Max-Ferrando/Proyecto3_ASIC_Grupo7/sim/asic/gen/game_rom.v

// GENERADO por tools/rvasm.py a partir de sw/game.s. NO EDITAR.
// Constantes redefinidas: CLK_HZ=20000
// ROM combinacional: 150 de 256 palabras usadas.
// Las direcciones sin programa devuelven 0 (instruccion ilegal).
module pochoco_game_rom (
  input  wire [7:0] addr_i,   // direccion de palabra
  output reg  [31:0] data_o
);
  always @* begin
    case (addr_i)
      8'd0: data_o = 32'h80000437;  // li   s0, PERIPH
      8'd1: data_o = 32'h000011b7;  // li   gp, 0x1234
      8'd2: data_o = 32'h23418193;
      8'd3: data_o = 32'h00042023;  // sw   zero, SEG_OFF(s0)
      8'd4: data_o = 32'h00100613;  // li   a2, 1
      8'd5: data_o = 32'h00c42223;  // sw   a2, LED_OFF(s0)
      8'd6: data_o = 32'h00001537;  // li   a0, IDLE_STEP
      8'd7: data_o = 32'hfa050513;
      8'd8: data_o = 32'h14c000ef;  // jal  ra, wait_or_press
      8'd9: data_o = 32'h00051c63;  // bnez a0, idle_pressed
      8'd10: data_o = 32'h00c60633;  // add  a2, a2, a2
      8'd11: data_o = 32'h01000293;  // li   t0, 16
      8'd12: data_o = 32'hfe5612e3;  // bne  a2, t0, idle_loop
      8'd13: data_o = 32'h00100613;  // li   a2, 1
      8'd14: data_o = 32'hfddff06f;  // j    idle_loop
      8'd15: data_o = 32'h00c42283;  // lw   t0, CYC_OFF(s0)
      8'd16: data_o = 32'h0051c1b3;  // xor  gp, gp, t0
      8'd17: data_o = 32'h150000ef;  // jal  ra, wait_release
      8'd18: data_o = 32'h00000493;  // li   s1, 0
      8'd19: data_o = 32'h00000213;  // li   tp, 0
      8'd20: data_o = 32'h00f00293;  // li   t0, 15
      8'd21: data_o = 32'h00542223;  // sw   t0, LED_OFF(s0)
      8'd22: data_o = 32'h0000f537;  // li   a0, ALL_ON_TIME
      8'd23: data_o = 32'ha6050513;
      8'd24: data_o = 32'h0f8000ef;  // jal  ra, delay
      8'd25: data_o = 32'h130000ef;  // jal  ra, wait_release
      8'd26: data_o = 32'h14c000ef;  // jal  ra, rand_led
      8'd27: data_o = 32'h00f42223;  // sw   a5, LED_OFF(s0)
      8'd28: data_o = 32'h00c42703;  // lw   a4, CYC_OFF(s0)
      8'd29: data_o = 32'h00c42583;  // lw   a1, CYC_OFF(s0)
      8'd30: data_o = 32'h00842503;  // lw   a0, BTN_OFF(s0)
      8'd31: data_o = 32'hfe050ce3;  // beqz a0, wait_press
      8'd32: data_o = 32'h40e585b3;  // sub  a1, a1, a4
      8'd33: data_o = 32'h00b181b3;  // add  gp, gp, a1
      8'd34: data_o = 32'h08f51863;  // bne  a0, a5, wrong_button
      8'd35: data_o = 32'h000302b7;  // li   t0, MAX_CYCLES
      8'd36: data_o = 32'h57028293;
      8'd37: data_o = 32'h0055e463;  // bltu a1, t0, no_sat
      8'd38: data_o = 32'h00028593;  // mv   a1, t0
      8'd39: data_o = 32'h00b20233;  // add  tp, tp, a1
      8'd40: data_o = 32'h3e800293;  // li   t0, HALF_TENTH
      8'd41: data_o = 32'h00558533;  // add  a0, a1, t0
      8'd42: data_o = 32'h7d000593;  // li   a1, TENTH
      8'd43: data_o = 32'h154000ef;  // jal  ra, udiv
      8'd44: data_o = 32'h16c000ef;  // jal  ra, to_bcd
      8'd45: data_o = 32'h00a42023;  // sw   a0, SEG_OFF(s0)
      8'd46: data_o = 32'h0dc000ef;  // jal  ra, wait_release
      8'd47: data_o = 32'h00148493;  // addi s1, s1, 1
      8'd48: data_o = 32'h00a00293;  // li   t0, NUM_ROUNDS
      8'd49: data_o = 32'hf854c6e3;  // blt  s1, t0, round_start
      8'd50: data_o = 32'h000022b7;  // li   t0, NUM_ROUNDS * TENTH / 2
      8'd51: data_o = 32'h71028293;
      8'd52: data_o = 32'h00520533;  // add  a0, tp, t0
      8'd53: data_o = 32'h000055b7;  // li   a1, NUM_ROUNDS * TENTH
      8'd54: data_o = 32'he2058593;
      8'd55: data_o = 32'h124000ef;  // jal  ra, udiv
      8'd56: data_o = 32'h13c000ef;  // jal  ra, to_bcd
      8'd57: data_o = 32'h00a42023;  // sw   a0, SEG_OFF(s0)
      8'd58: data_o = 32'h00500613;  // li   a2, 5
      8'd59: data_o = 32'h00c42223;  // sw   a2, LED_OFF(s0)
      8'd60: data_o = 32'h00001537;  // li   a0, IDLE_STEP
      8'd61: data_o = 32'hfa050513;
      8'd62: data_o = 32'h074000ef;  // jal  ra, wait_or_press
      8'd63: data_o = 32'h00051663;  // bnez a0, end_pressed
      8'd64: data_o = 32'h00f64613;  // xori a2, a2, 15
      8'd65: data_o = 32'hfe9ff06f;  // j    end_loop
      8'd66: data_o = 32'h00c42283;  // lw   t0, CYC_OFF(s0)
      8'd67: data_o = 32'h0051c1b3;  // xor  gp, gp, t0
      8'd68: data_o = 32'h084000ef;  // jal  ra, wait_release
      8'd69: data_o = 32'hef9ff06f;  // j    new_game
      8'd70: data_o = 32'h0ee00293;  // li   t0, ERR_CODE
      8'd71: data_o = 32'h00542023;  // sw   t0, SEG_OFF(s0)
      8'd72: data_o = 32'h074000ef;  // jal  ra, wait_release
      8'd73: data_o = 32'h00300613;  // li   a2, ERR_BLINKS
      8'd74: data_o = 32'h00f00293;  // li   t0, 15
      8'd75: data_o = 32'h00542223;  // sw   t0, LED_OFF(s0)
      8'd76: data_o = 32'h00001537;  // li   a0, BLINK_TIME
      8'd77: data_o = 32'hbb850513;
      8'd78: data_o = 32'h020000ef;  // jal  ra, delay
      8'd79: data_o = 32'h00042223;  // sw   zero, LED_OFF(s0)
      8'd80: data_o = 32'h00001537;  // li   a0, BLINK_TIME
      8'd81: data_o = 32'hbb850513;
      8'd82: data_o = 32'h010000ef;  // jal  ra, delay
      8'd83: data_o = 32'hfff60613;  // addi a2, a2, -1
      8'd84: data_o = 32'hfc061ce3;  // bnez a2, err_loop
      8'd85: data_o = 32'hefdff06f;  // j    round_start
      8'd86: data_o = 32'h00c42283;  // lw   t0, CYC_OFF(s0)
      8'd87: data_o = 32'h00c42303;  // lw   t1, CYC_OFF(s0)
      8'd88: data_o = 32'h40530333;  // sub  t1, t1, t0
      8'd89: data_o = 32'hfea36ce3;  // bltu t1, a0, delay_loop
      8'd90: data_o = 32'h00008067;  // ret
      8'd91: data_o = 32'h00c42283;  // lw   t0, CYC_OFF(s0)
      8'd92: data_o = 32'h00842303;  // lw   t1, BTN_OFF(s0)
      8'd93: data_o = 32'h00031c63;  // bnez t1, wop_hit
      8'd94: data_o = 32'h00c42383;  // lw   t2, CYC_OFF(s0)
      8'd95: data_o = 32'h405383b3;  // sub  t2, t2, t0
      8'd96: data_o = 32'hfea3e8e3;  // bltu t2, a0, wop_loop
      8'd97: data_o = 32'h00000513;  // li   a0, 0
      8'd98: data_o = 32'h00008067;  // ret
      8'd99: data_o = 32'h00030513;  // mv   a0, t1
      8'd100: data_o = 32'h00008067;  // ret
      8'd101: data_o = 32'h19000693;  // li   a3, DEBOUNCE
      8'd102: data_o = 32'h00c42283;  // lw   t0, CYC_OFF(s0)
      8'd103: data_o = 32'h00842303;  // lw   t1, BTN_OFF(s0)
      8'd104: data_o = 32'hfe031ce3;  // bnez t1, wr_restart
      8'd105: data_o = 32'h00c42383;  // lw   t2, CYC_OFF(s0)
      8'd106: data_o = 32'h405383b3;  // sub  t2, t2, t0
      8'd107: data_o = 32'hfed3e8e3;  // bltu t2, a3, wr_loop
      8'd108: data_o = 32'h00008067;  // ret
      8'd109: data_o = 32'h003182b3;  // add  t0, gp, gp
      8'd110: data_o = 32'h005282b3;  // add  t0, t0, t0
      8'd111: data_o = 32'h003281b3;  // add  gp, t0, gp
      8'd112: data_o = 32'h000032b7;  // li   t0, LCG_INC
      8'd113: data_o = 32'h03928293;
      8'd114: data_o = 32'h005181b3;  // add  gp, gp, t0
      8'd115: data_o = 32'h00c42283;  // lw   t0, CYC_OFF(s0)
      8'd116: data_o = 32'h005181b3;  // add  gp, gp, t0
      8'd117: data_o = 32'h00100793;  // li   a5, 1
      8'd118: data_o = 32'h00010337;  // lui  t1, 0x10
      8'd119: data_o = 32'h0061f2b3;  // and  t0, gp, t1
      8'd120: data_o = 32'h00028463;  // beqz t0, rl_bit17
      8'd121: data_o = 32'h00f787b3;  // add  a5, a5, a5
      8'd122: data_o = 32'h00630333;  // add  t1, t1, t1
      8'd123: data_o = 32'h0061f2b3;  // and  t0, gp, t1
      8'd124: data_o = 32'h00028663;  // beqz t0, rl_done
      8'd125: data_o = 32'h00f787b3;  // add  a5, a5, a5
      8'd126: data_o = 32'h00f787b3;  // add  a5, a5, a5
      8'd127: data_o = 32'h00008067;  // ret
      8'd128: data_o = 32'h00000293;  // li   t0, 0
      8'd129: data_o = 32'h00b56863;  // bltu a0, a1, udiv_done
      8'd130: data_o = 32'h40b50533;  // sub  a0, a0, a1
      8'd131: data_o = 32'h00128293;  // addi t0, t0, 1
      8'd132: data_o = 32'hff5ff06f;  // j    udiv_loop
      8'd133: data_o = 32'h00028513;  // mv   a0, t0
      8'd134: data_o = 32'h00008067;  // ret
      8'd135: data_o = 32'h06300293;  // li   t0, MAX_TENTHS
      8'd136: data_o = 32'h00a2f463;  // bgeu t0, a0, bcd_ok
      8'd137: data_o = 32'h00028513;  // mv   a0, t0
      8'd138: data_o = 32'h00000313;  // li   t1, 0
      8'd139: data_o = 32'h00a00293;  // li   t0, 10
      8'd140: data_o = 32'h00556863;  // bltu a0, t0, bcd_pack
      8'd141: data_o = 32'hff650513;  // addi a0, a0, -10
      8'd142: data_o = 32'h00130313;  // addi t1, t1, 1
      8'd143: data_o = 32'hff5ff06f;  // j    bcd_loop
      8'd144: data_o = 32'h00630333;  // add  t1, t1, t1
      8'd145: data_o = 32'h00630333;  // add  t1, t1, t1
      8'd146: data_o = 32'h00630333;  // add  t1, t1, t1
      8'd147: data_o = 32'h00630333;  // add  t1, t1, t1
      8'd148: data_o = 32'h00a30533;  // add  a0, t1, a0
      8'd149: data_o = 32'h00008067;  // ret
      default: data_o = 32'h00000000;
    endcase
  end
endmodule
