Max-Ferrando/Proyecto3_ASIC_Grupo7/(commit log)

2026-10-26 Proyecto 3: RTL ASIC, memorias, configs LibreLane y scripts
    [pin_order.cfg]
2026-10-27 Proyecto 3: corridas finales, barridos, correcciones y README con versiones
    [pin_order.cfg, sweep_CLOCK_PERIOD.csv, sweep_FP_CORE_UTIL.csv]
2026-10-27 Informe final Proyecto 3 (completo) + permisos de scripts
